SysMC/MBeeCayenneWiFiMonitoringAndManagement/MB-SensorBoard .jpg

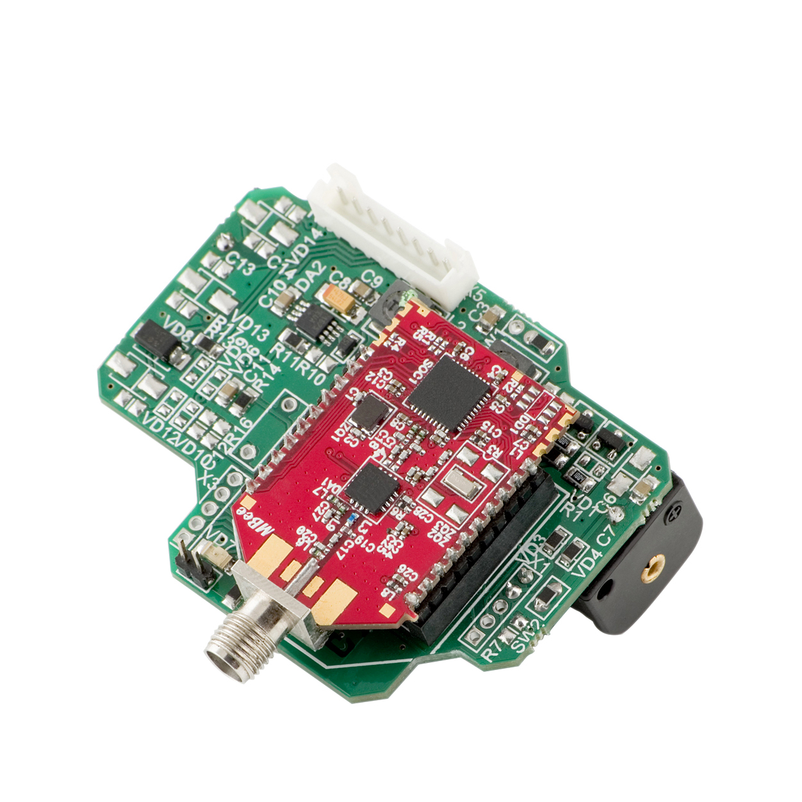
MB-SensorBoard .jpg
