SysMC/MBeeCayenneWiFiMonitoringAndManagement/README.md

# MBeeCayenneWiFiMonitoringAndManagement
