SysMC/MBeeCayenneWiFiMonitoringAndManagement/Specification MB-Gateway-1.1.xls

Спецификация на MB-Gateway-1.1
 |  |  |  | Количество = | 1
Название | Корпус | Описание | Обозначение | x 1 | x N
Микросхемы
LM1117-3.3 | SOT223 |  | DA1 | 1 | 1
Диоды и стабилзаторы
Светодиод зеленый | 0805 |  | VD2, VD3, VD5 | 3 | 3
Светодиод красный |  |  | VD4 | 1 | 1
Светодиод белый | 0805 |  | VD1 | 1 | 1
Конденсаторы
0,1 uF | 0805 |  | С1, C2, C4 | 3 | 3
470 uF 6,3V | 0805 |  | C5 | 1 | 1
Индуктивности
TB2012 09 B 070 | 0805 |  | L1 | 1 | 1
Резисторы
1 KOhm | 0805 |  | R2, R3, R4, R5, R6, R7 | 6 | 6
100 Ohm | 0805 |  | R1 | 1 | 1
Прочее
Protoboard |  | Плата печатная | MBee Gateway | 1 | 1
MBee-868-2.0-WIRE-PLS12 |  |  | MOD1 | 1 | 1
ESP8266 |  | Wi-Fi module | MOD2 | 1 | 1
USB_B |  |  | X2 | 1 | 1
BH10 |  |  | X1 | 1 | 1
PLD-8 |  |  |  | 1 | 1
PLS2-12 |  |  |  | 2 | 2
PLS2 |  |  | SW1 | 1 | 1
Корпус G436 |  |  | G436 | 1 | 1
Jumper |  |  |  | 1 | 1
SWT6x3 |  |  | S1, S2 | 2 | 2
