SysMC/MBeeCayenneWiFiMonitoringAndManagement/zelo-ac-dc_scheme2.jpg

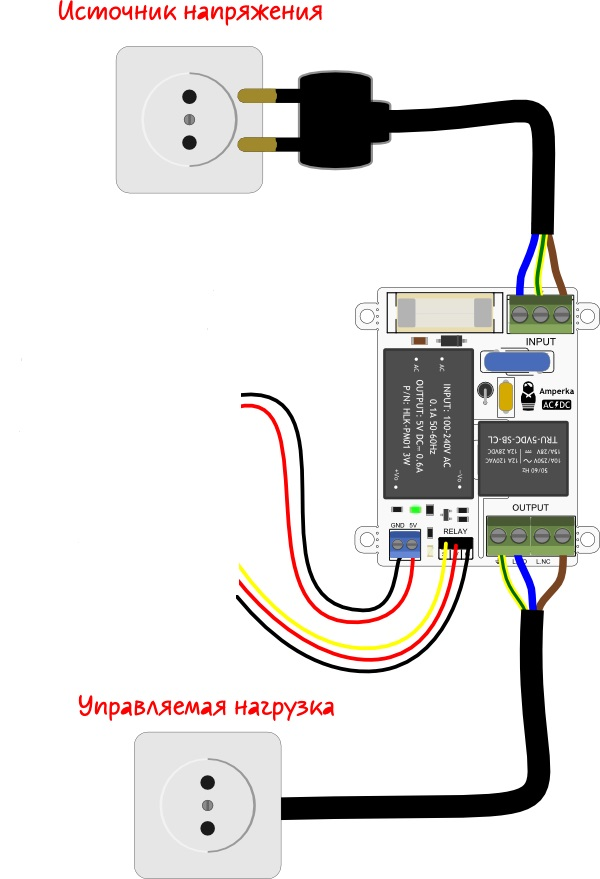
zelo-ac-dc_scheme2.jpg
