SysMC/MBeeCayenneWiFiMonitoringAndManagement/MB-Gateway shematic.pdf

R1 100 | R2 1K

### MOD2

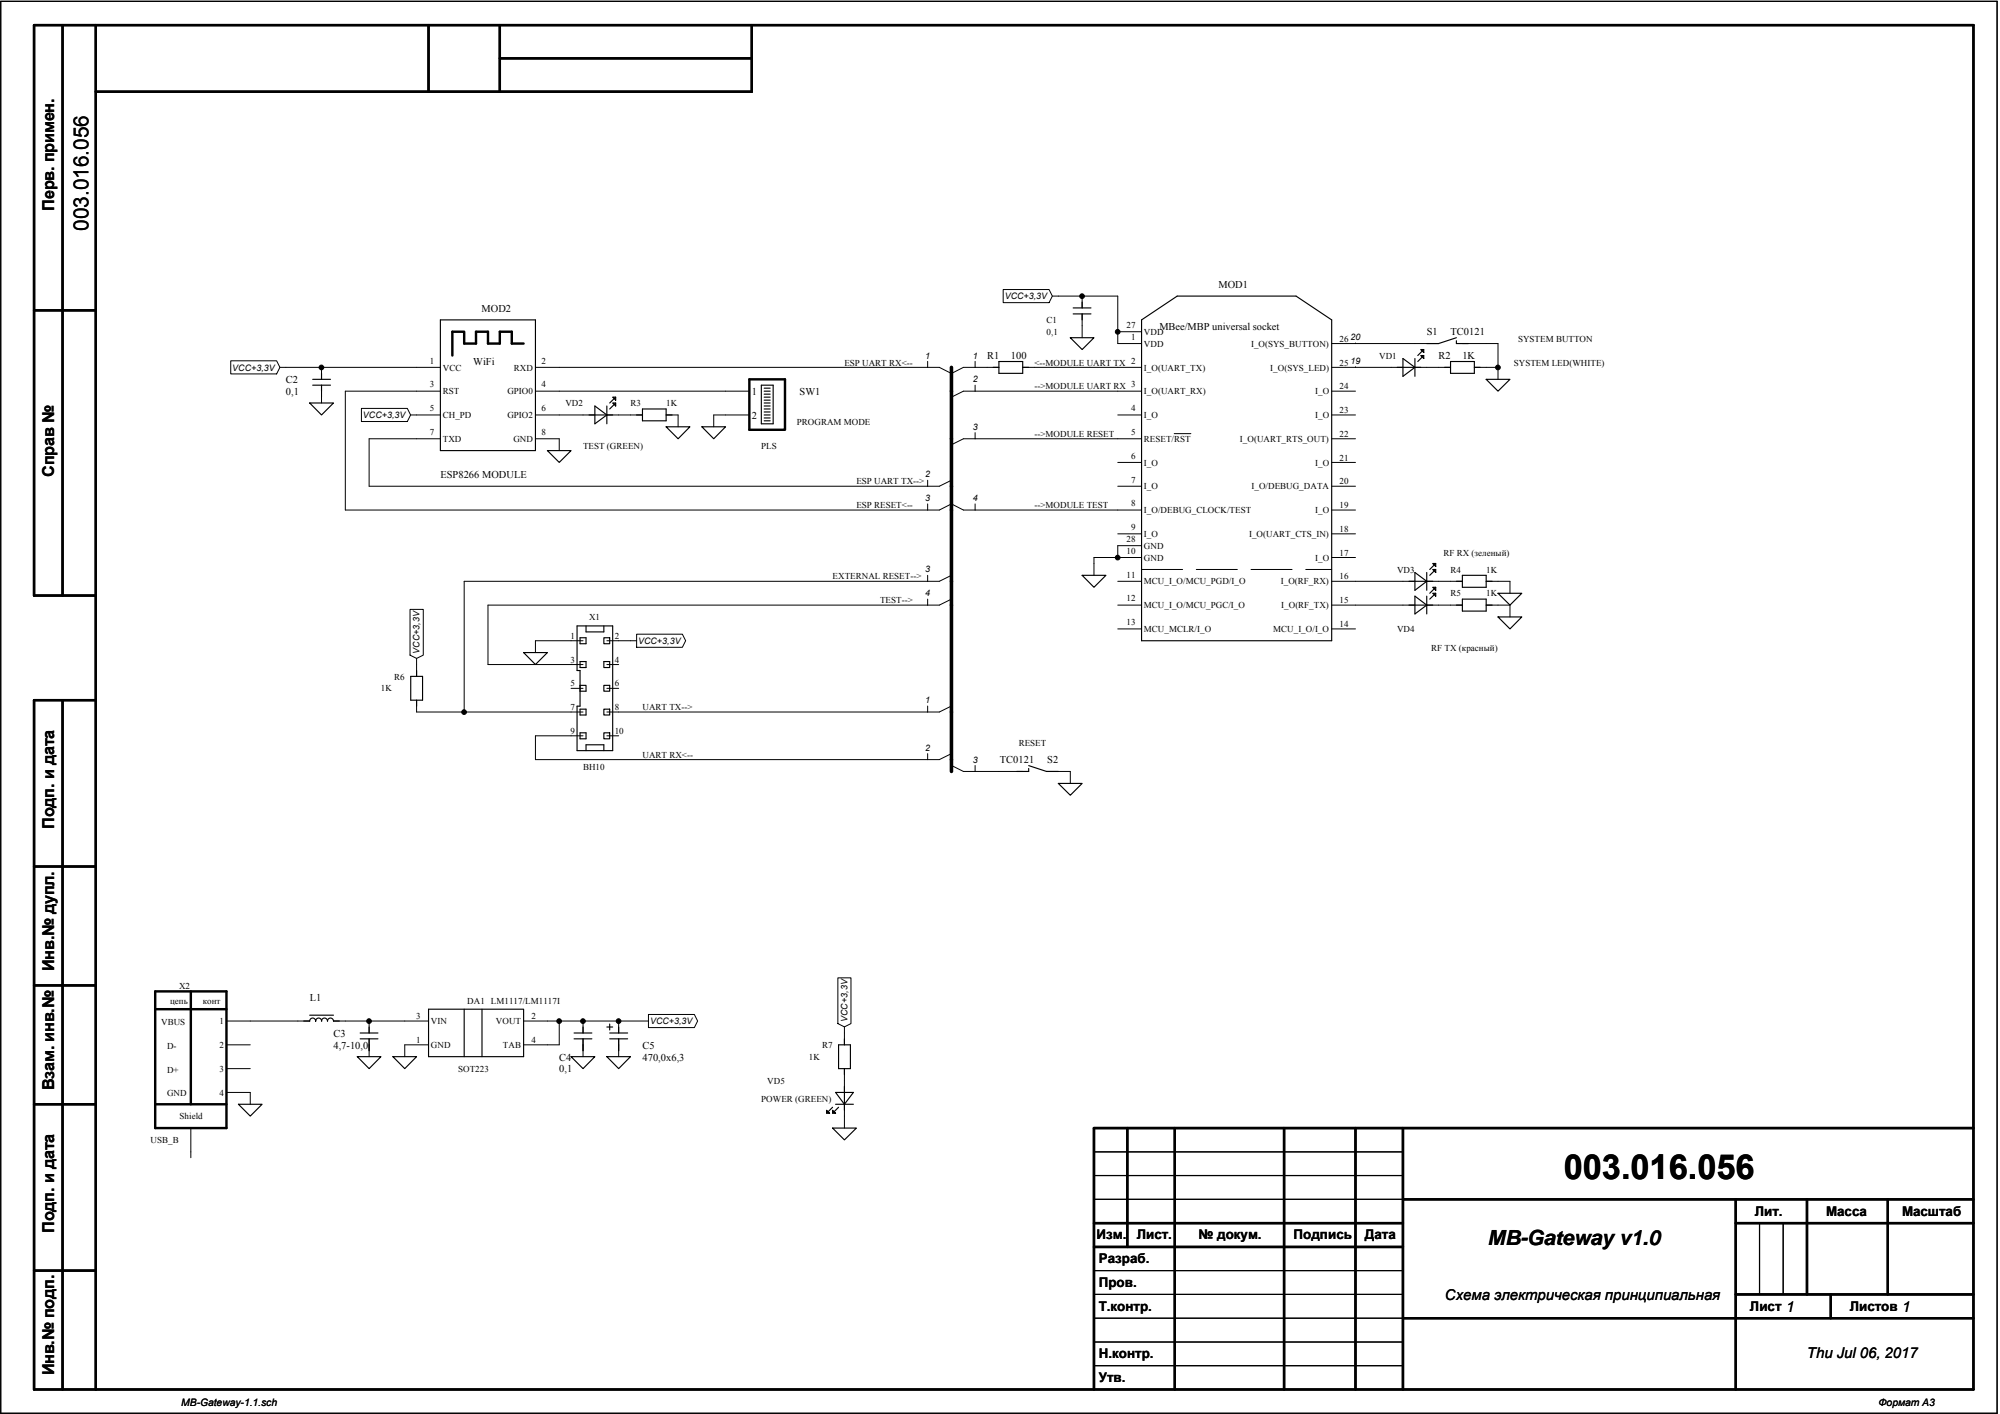
[picture p3: page 1]

Справ № Инв.№ подп. Перв. примен.

Подп. и дата Взам. инв.№ Инв.№ дупл. Подп. и дата

цепь | конт

VBUS D-D+ GND | 1 2 3 4

MB-Gateway v1.0 MB-Gateway v1.0 Схема электрическая принципиальная Схема электрическая принципиальная | Лит. | Масса | Масштаб
Изм. | Лист. | № докум. | Подпись | Дата
Разраб.
Пров.
Т.контр. | | | | | Лист 1 | Листов Листов 1 1

Н.контр.
Утв.

Thu Jul 06, 2017
